adam-sampson/DigitalCompass/img/2471483_orig.jpg

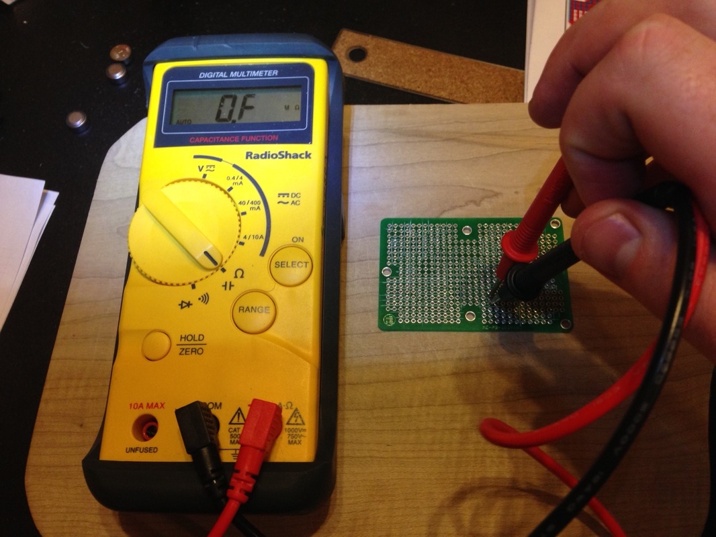
img/2471483_orig.jpg
