adam-sampson/DigitalCompass/img/6412650_orig.jpg

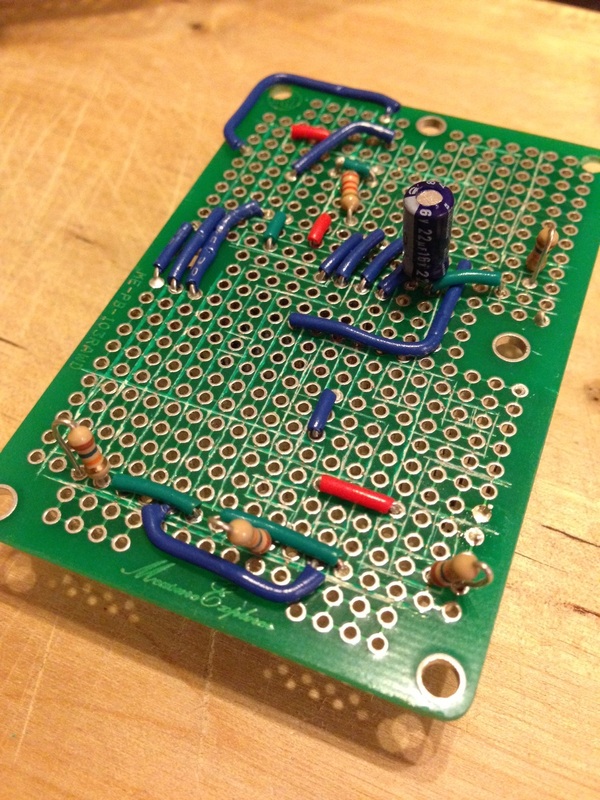
img/6412650_orig.jpg
