adam-sampson/DigitalCompass/img/9402347_orig.jpg

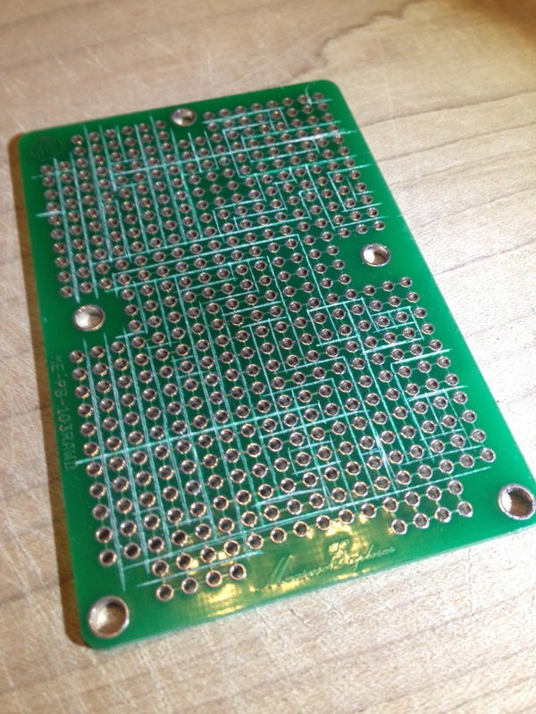
img/9402347_orig.jpg
